iansan5653/iansan5653.github.io/README.md

The source code for my personal site at <a href="https://iansanders.blog/">iansanders.blog</a>. This site is a study in resisting my tendency to overcomplicate things; I will try to keep it as low-fidelity as possible.
