iansan5653/iansan5653.github.io/lewmar-traveler-rebuild/pin-retainer.stl

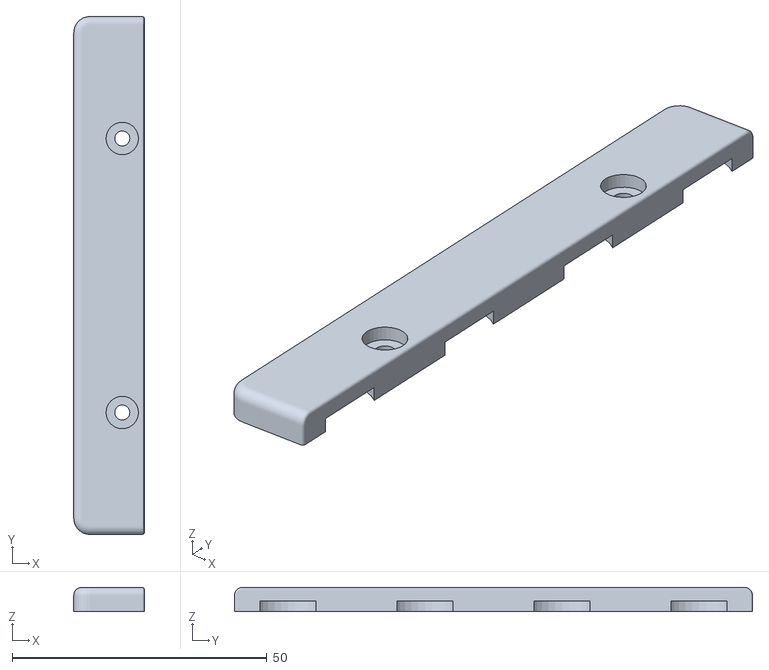
[picture p1: CAD file, 2026-02-28]
lewmar-traveler-rebuild/pin-retainer.stl
13.8 x 101.6 x 4.76
