iansan5653/iansan5653.github.io/lewmar-traveler-rebuild/index.html

March 2, 2026

# Lewmar Solent Traveler Rebuild

Endeavour, my 1988 Caliber 28, is equipped with an original Lewmar Solent mid-boom mainsheet system with a cabintop traveler. This is a great setup for a cruiser — it allows for a huge range of mainsheet trim positions while keeping the cockpit completely free. However, this setup creates especially high loads on the traveler, so it must be robust and well-maintained.

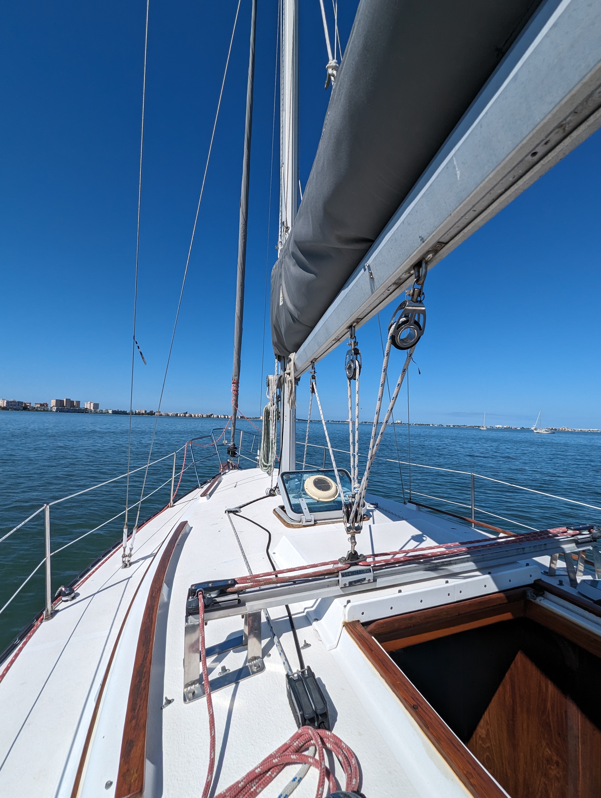
[picture p2: lewmar-traveler-rebuild/original-traveler-full-view.jpg]
View of entire traveler: the car runs on a straight track which stretches across the cabintop in front of the companionway.


Endeavour's cabintop traveler when I purchased her in May 2024.

However, when I first purchased the vessel, her traveler was in very rough shape. It could only be adjusted when completely unloaded, an unacceptable state for such a critical component. The blocks didn't spin, the control lines were stiff and worn, and most importantly, the roller bearings didn't roll at all.

New traveler systems are sexy and tempting, but they also cost several thousand dollars. Even just replacing the car wasn't an option in this case because Lewmar doesn't make any cars that are compatible with the old Solent tracks, and my extensive eBay searching failed to turn up a single promising result.

So I was very motivated to find a way to bring this gear back to life. Thankfully, with some creativity and effort, I was able to do so. Fair warning: this will be a long article, somewhere in between a tutorial and a narrative about the engineering and design process. I hope you find it interesting enough to stick with me.

## Disassembly

For instructions on disassembling this traveler system as well as an overview of how it works, I'll refer you to this excellent Lewmar Traveler Maintenance (https://www.foghornlullaby.com/2019/04/lewmar-traveller-maintenance/) article from Foghorn Lullaby.

There is only one caution I would add to this article for those attempting this themselves: be careful not to allow the wheels or pins to drop overboard when removing the car from the track! The track is what holds them into the car; when the car is removed, they are free to fall out. If you have access to a 3D printer, I have designed a 3D-printable piece of track section which can be used use to contain the wheels.

## Rebuilding the car

The car runs on 8 wheels, which roll alongside the bottom side of the top edge of the track when the car is loaded. These wheels are ball bearings in plastic housings, and are held in place by steel axle pins. These pins are only held in place by the track itself.

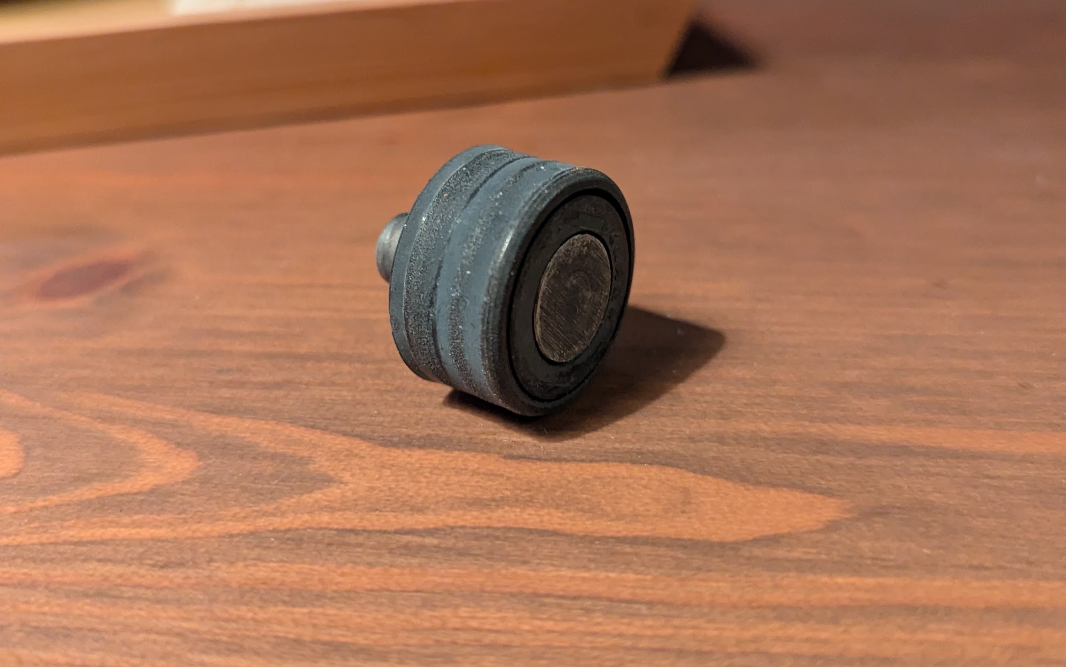
[picture p3: lewmar-traveler-rebuild/original-wheel-axle.jpg]
Close-up of a plastic wheel on a metal axle; wheel shows significant wear.


One of the eight wheels and its axle.

Careful examination of the car and track showed several significant issues. First, the plastic bearing housings had become brittle and worn down over time. A few of the bearings had failed completely.

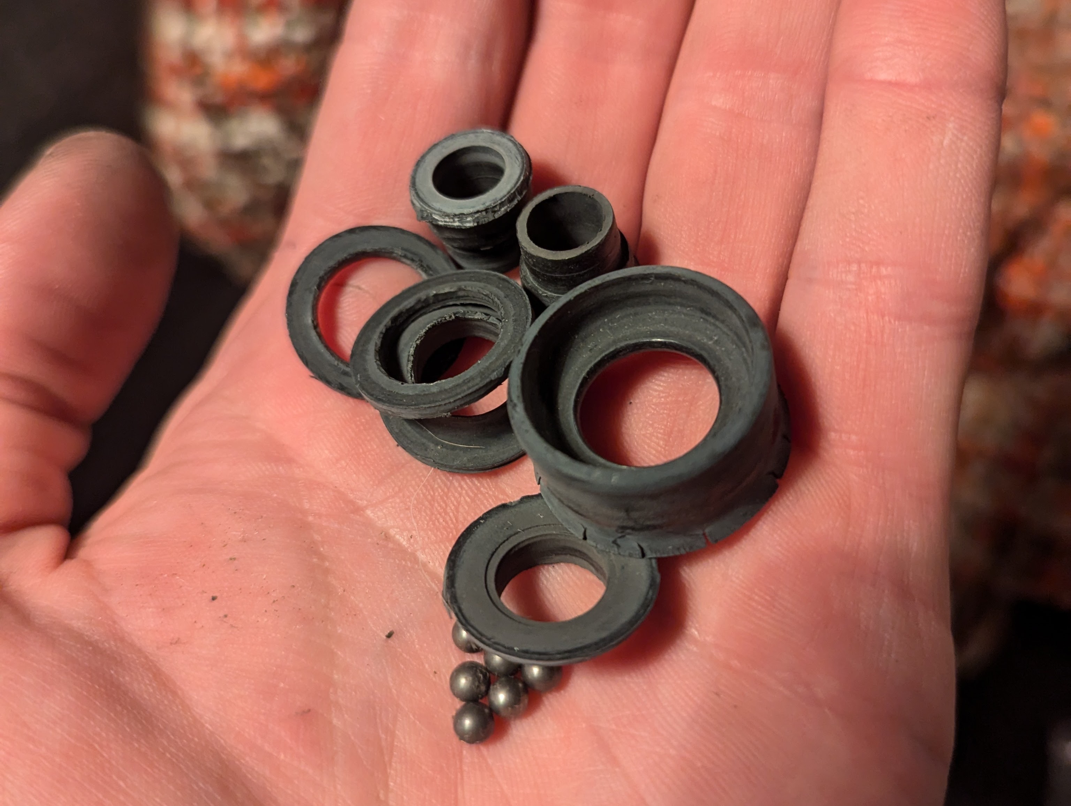
[picture p4: lewmar-traveler-rebuild/failed-bearing-pieces.jpg]
Pieces of a failed bearing including a broken plastic housing and several metal balls.


This bearing crumbled when I removed it from the axle.

The second issue was a design flaw from the manufacturer: because the pins are only held in place by the track, they can shift inwards slightly. This allows them to rub against the track, causing wear. It also reduces the amount of material holding them in place, allowing them to shift slightly and loading them at an angle.

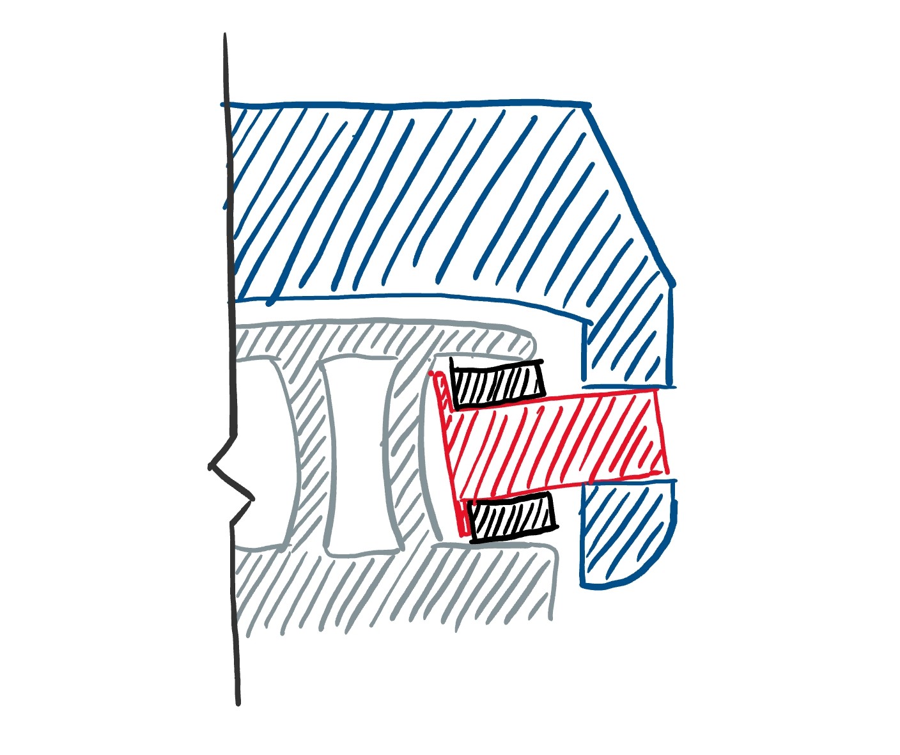
[picture p5: lewmar-traveler-rebuild/sketch-pin-misalignment.jpg]
Sketch of the pins housing in the car, showing how they can scrape against the edge of the track by shifting out of their housing towards the track.


Cutaway drawing showcasing the pins' design flaw.

My first attempt at a solution was to replace the bearings with new off-the-shelf components. Their dimensions are very similar to standard 608 bearings, and I even managed to find and purchase some of these in marine-grade 316 stainless steel. However, when I received the bearings I decided that the dimensions weren't close enough (they were too narrow) and, more importantly, I didn't want to have steel wheels wearing on my aluminum track.

Returning to the drawing board, my only option was to create new bearings. In the interest of strength, durability, and simplicity, I decided to move from ball bearings to plain bearings. Custom plain bearings could be manufactured relatively easily, and careful material selection would still minimize friction. In fact, under very high loads, plain bearings typically perform better than ball bearings anyway.

The bearings need to have a 1" outer diameter, 5/16" inner diameter, and be 1/2" wide. For the wheel I selected Delrin plastic as a durable but easily machinable wheel material. McMaster-Carr sells a 1" cylinder of black Delrin as part #8576K21 (https://www.mcmaster.com/catalog/132/4139/8576K21). I probably could have had the Delrin bear directly on the shaft without much issue, but I wanted to minimize friction as much as possible. So I designed my wheels with an oil-impregnated sleeve bearing that actually runs on the shaft (McMaster-Carr #2868T55 (https://www.mcmaster.com/products/2868t55/)).

With these parts acquired, all I had to do was hire a local machine shop to cut the bar into 10 (8 plus 2 spares) 1/2" discs, cut a 3/8" hole in the center, and press-fit the bearing sleeves.

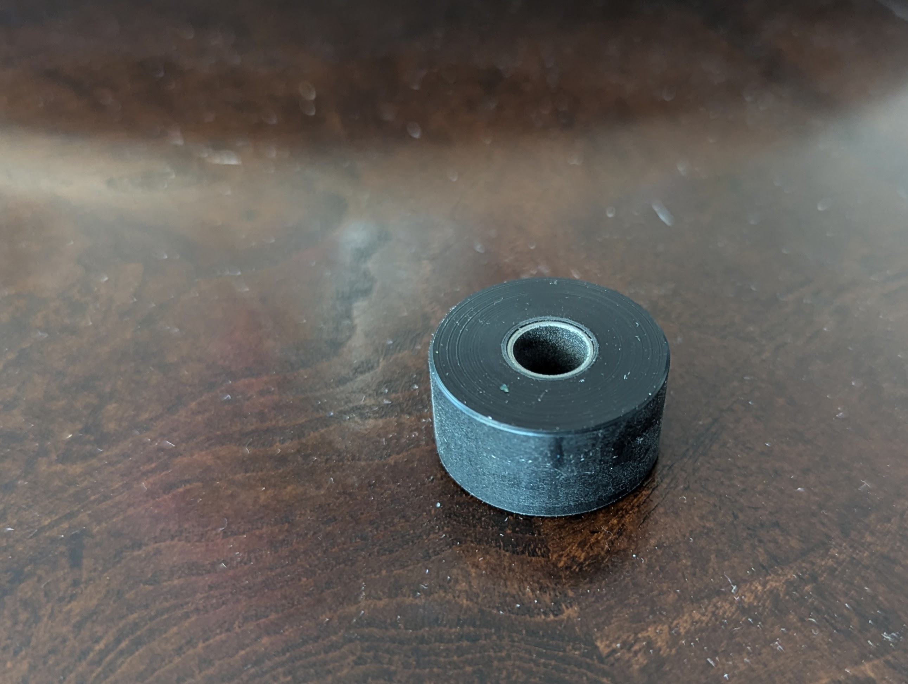
[picture p6: lewmar-traveler-rebuild/new-wheel.jpg]
Close-up of a new machined black plastic wheel with metal sleeve bearing installed.
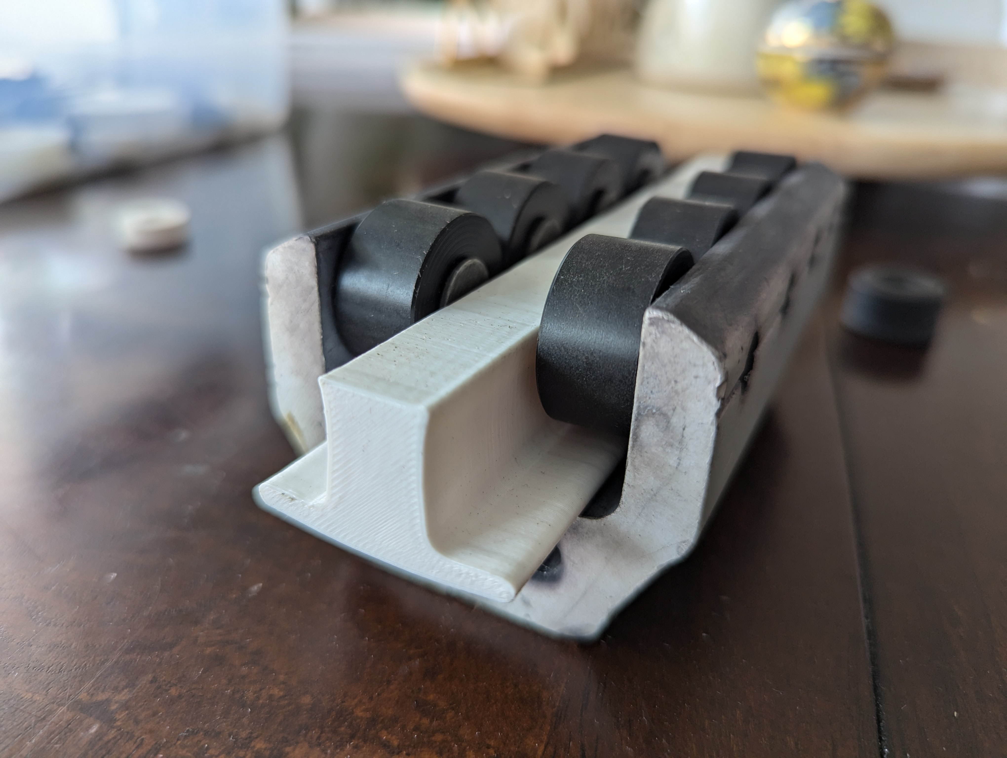
[picture p7: lewmar-traveler-rebuild/new-wheels-installed.jpg]
Traveler car with eight new wheels installed with pins in original orientation, shown on a plastic track segment.
 

Newly machined wheels for the traveler car.

The new wheels were perfect, however they alone could't solve the design flaw that allowed the pins to wear on the traveler and become crooked. I thought I might be able to get away without resolving that issue, but after trying it out I realized there was no way around it — I had to re-engineer the whole assembly.

At this point it struck me that the whole issue would be solved if the pins just faced the other way. If the heads of the pins were on the exterior of the car, they wouldn't be able to rub against the track. And they would fit all the way through the car, so they couldn't be pulled out of alignment.

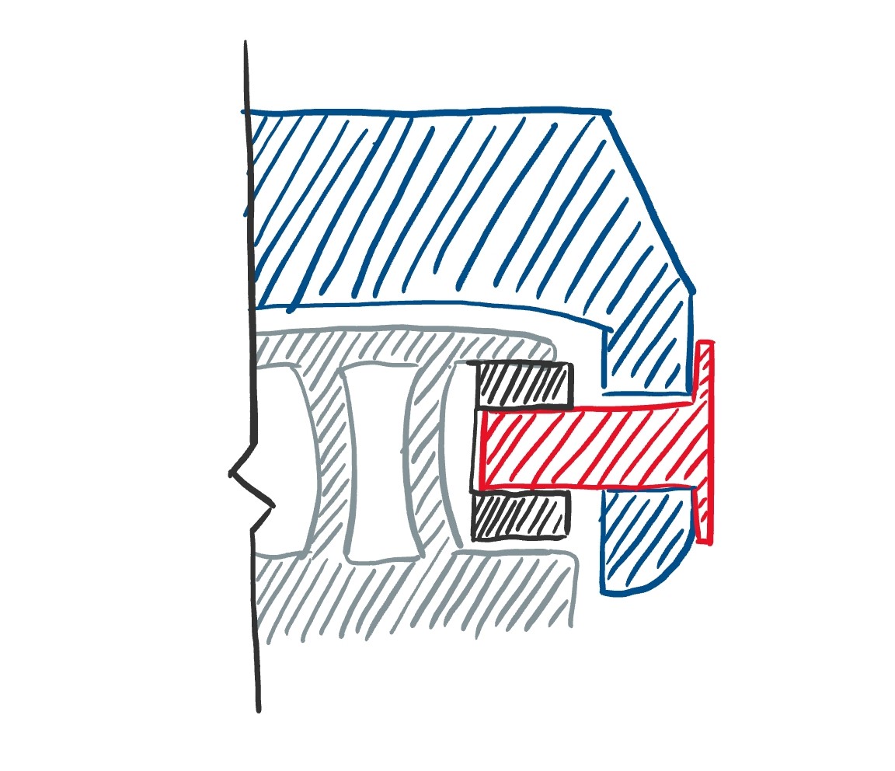
[picture p8: lewmar-traveler-rebuild/sketch-pin-reversed.jpg]
Cutaway sketch of reversed pins in housing; head of pins is now on exterior of car and so they cannot scrape against the track, and the full length of the pin is supported to prevent them from becom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


How reversing the pins would solve the problems.

However, I couldn't just reverse the pins. In that direction, there would be nothing stopping them from just falling out — I needed to retain them somehow.

To hold the pins in place, I designed and 3D printed a simple retainer from PETG plastic. This can be low-profile and lightweight because it doesn't need to support much load; it just stops the pins from falling out of place. The retainer is held onto the car by two small 4-40 machine screws, installed in holes I drilled and tapped at home. View and download the 3D model file here. (https://github.com/iansan5653/iansan5653.github.io/blob/main/lewmar-traveler-rebuild/pin-retainer.html)

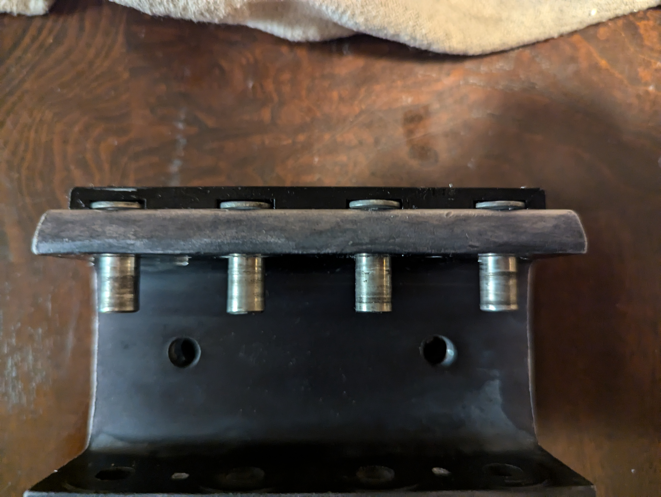
[picture p9: lewmar-traveler-rebuild/pin-retainer-bottom-view.jpg]
View of bottom of car showing four pins in reversed position, held in place by a black plastic cover piece on the exterior of the car.
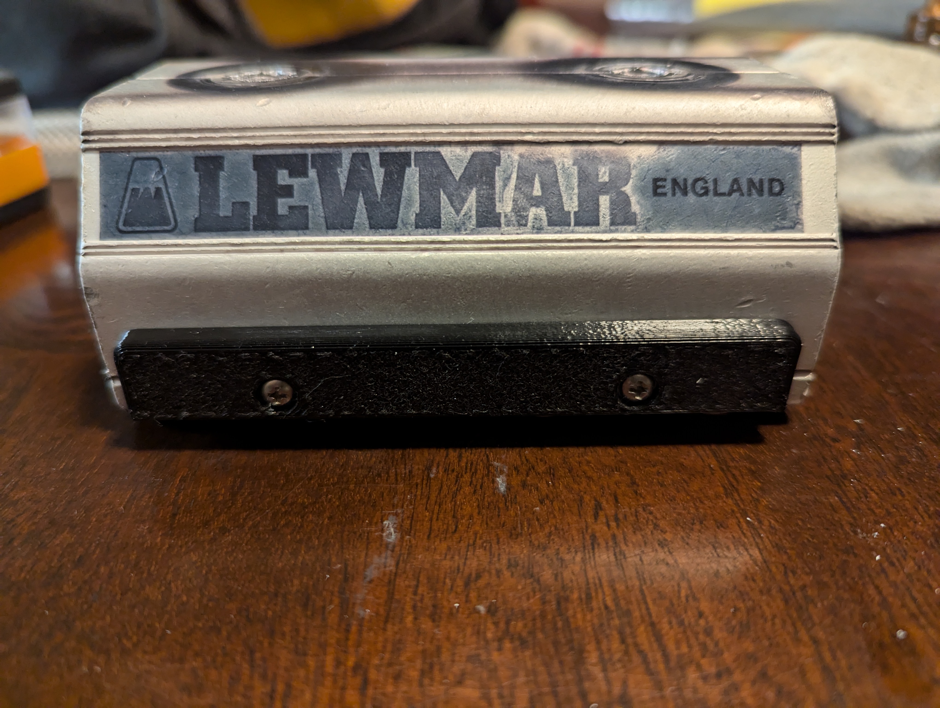
[picture p10: lewmar-traveler-rebuild/pin-retainer-side-view.jpg]
Exterior side of the car, highlighting the cover piece and two small screws holding it in place.
 

The new pin retainer in action.

With the wheel bearing and pin issues finally resolved, the car almost rolled perfectly on the track. However, I still noticed some extra friction caused by the wheels rubbing against the inside wall of the car. So I added some thin PTFE washers between the wheels and interior of the car to provide a smoother bearing surface. These are McMaster-Carr part #90334A254 (https://www.mcmaster.com/90334A254/).

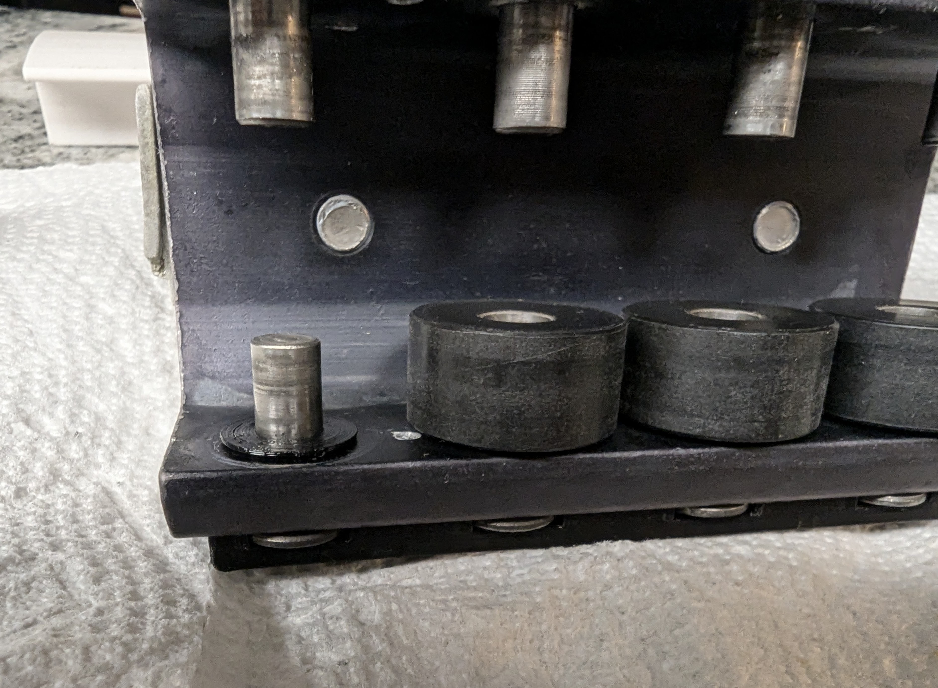
[picture p11: lewmar-traveler-rebuild/washer-bearings.jpg]
Image highlighting washer bearing installations: One axle is visible without a wheel, showing how the washer sits against the interior side of the car. The other wheels are present, showing how the 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


Washer bearings installed at each wheel.

Finally, the car is rolling like a dream, even under extremely high loads. And I am confident it is bulletproof.

## Improving control lines

With the car running smoothly, the only remaining issue was the control lines. Replacing the line was easy (I used 10mm New England Ropes Sta-Set), but the plastic sheaves were brittle and ran poorly after sitting in the sun for several decades.

I wanted to upgrade the sheaved to ball bearings. I figured since I had changed out the wheels for plain bearings, upgrading the rope sheaves to ball bearings would offset any increase in friction. And I just always prefer ball bearing blocks onboard.

All the major gear manufacturers offer a line of housingless ball bearing sheaves, so upgrading was just a matter of finding sheaves that fit. After extensive research I was able to track down suitable replacements: Lewmar Size 2 ball bearing sheaves come in a pack of four, which is great for the two traveler car sheaves and the small end block sheaves. Vela Sailing Supply sells them under part #LEW29472970BK (https://velasailingsupply.com/products/lewmar-size-2-ball-bearing-sheave-pack-of-4).

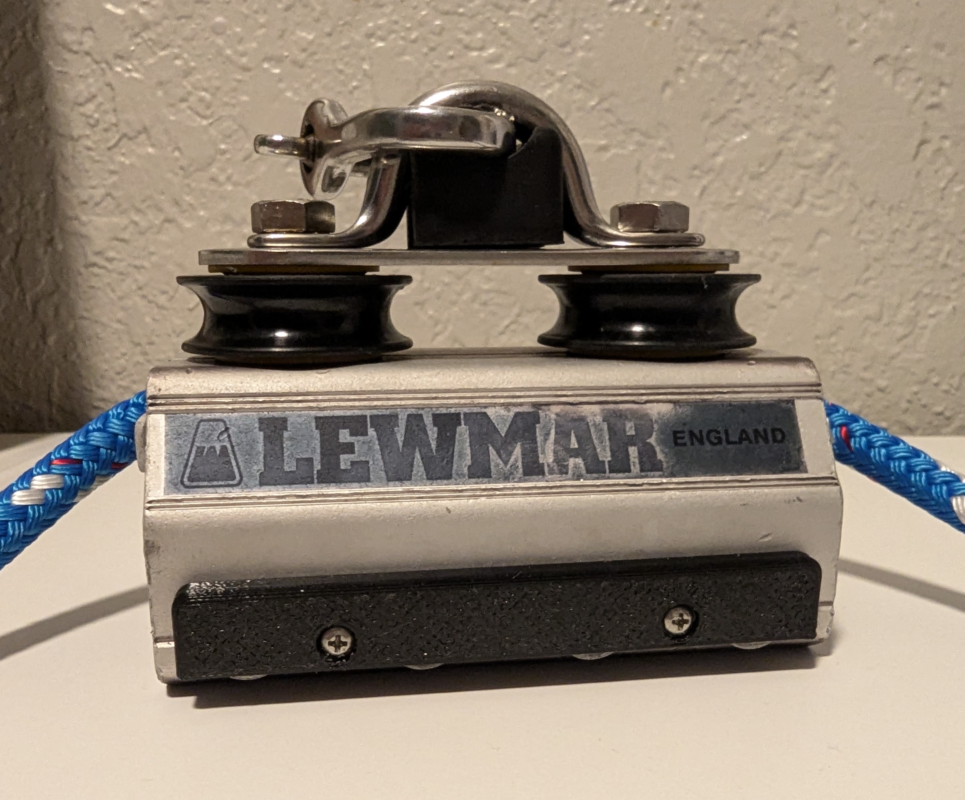
[picture p12: lewmar-traveler-rebuild/reassembled-car.jpg]
Exterior side view of reassembled car with new ball bearing sheaves, new blue control line, and black plastic pin retainer visible.


Reassembled car with new sheaves and line.

Note: When reassembling the car, it's critically important to grease the threads of all the stainless screws with Tef-Gel or similar to prevent siezing.

The 1/4" inner diameter is perfect for the car but slightly too large for the 3/16" screws that hold the end stops together. However that hasn't been a problem for me.

For the large sheaves on the end blocks, Harken's 57mm Delrin sheave is almost perfect. The only problem is that it's just slightly narrower than the Lewmar sheave. The extra space can be easily shimmed with a standard washer.

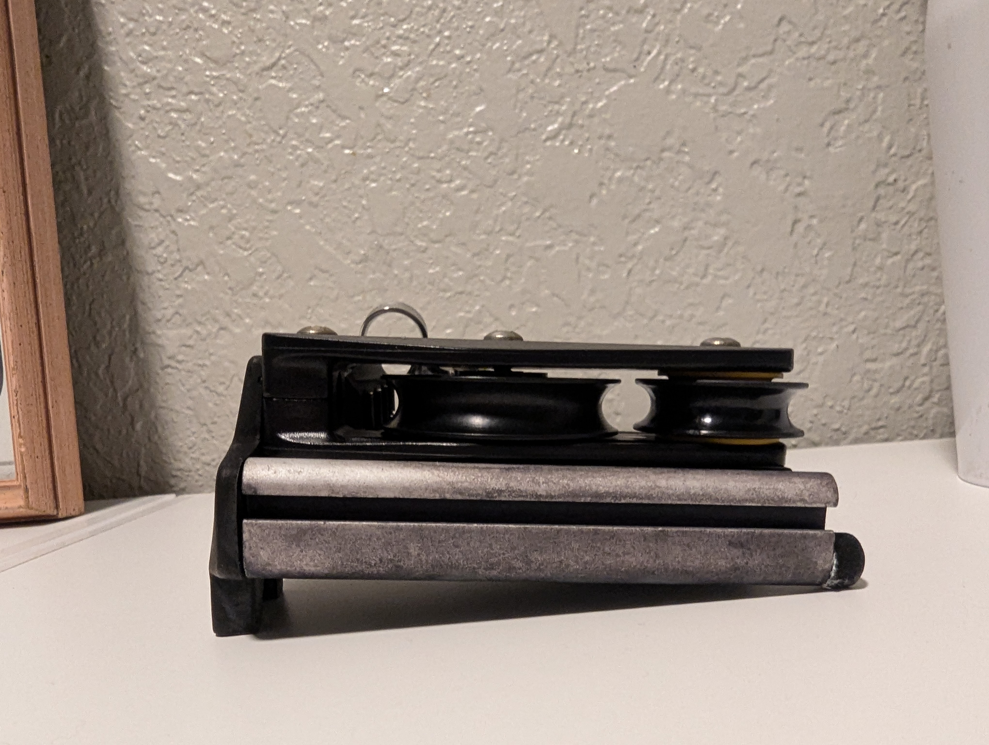
[picture p13: lewmar-traveler-rebuild/end-stop-new-sheave-without-shim.jpg]
New sheaves installed without washer shim; the top side of the end block is bent slightly inwards because there is extra space between the middle sheave and the cheek of the block.
 Washer installed between the bottom edge of the sheave and the bottom cheek of the block, supporting the middle of the block to avoid bending.

A standard washer fills the extra space and distributes the load on the housing.

I also disassembled, cleaned up, and oiled the cam cleats, but I haven't replaced them as they still work great. If I ever do decide to replace them, I think any standard camcleat such as the ones Ronstan sells would fit perfectly.

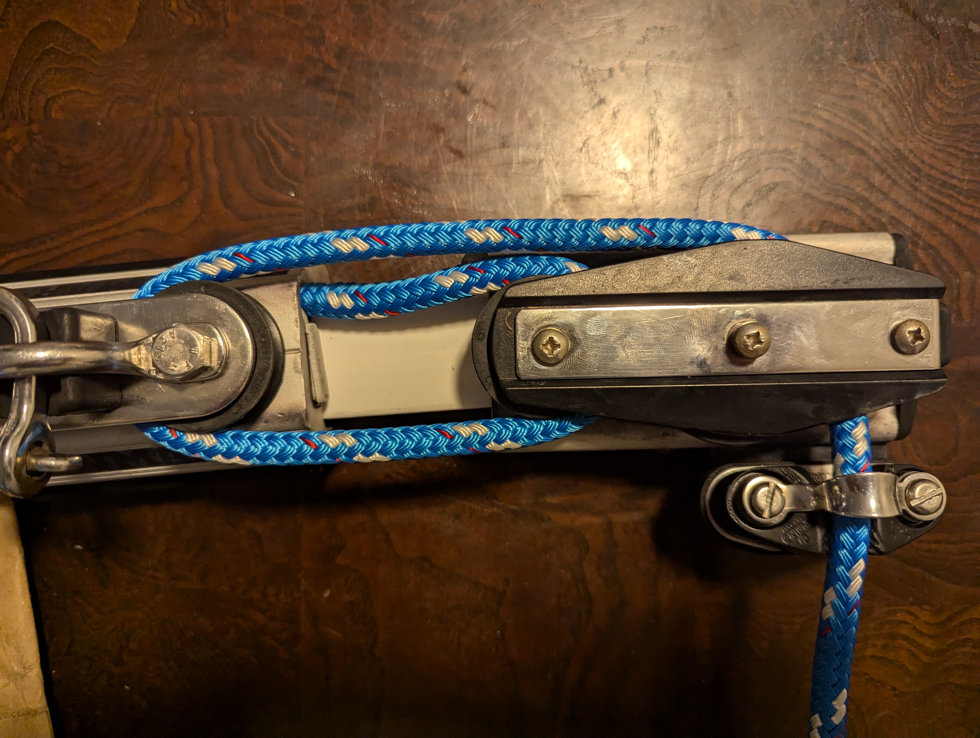
[picture p14: lewmar-traveler-rebuild/assembled-new-control-lines.jpg]
Closeup view of one end of the reassembled traveler highlighting the new control line set up in a 3:1 purchase.
 View of the fully reassembled traveler system onboard the vessel.

Endeavour's newly rebuilt traveler installed and ready for sailing.

I completed this project more than two years ago (which sure sounds better than "I procrastinated on writing this article for two years") and the new traveler has been absolutely perfect ever since! I've sailed in heavy weather, survived one or two crash gybes, and put about 1,500 nm on the boat since then, and I am pleased to report not a single further problem with it.
